eSpark-Consulting-Group/chrisbyrd-remotesensorunit/Design Files/Remote_Sensor_Unit/Deliverables/_Renderings/3D_Isometric_View.png

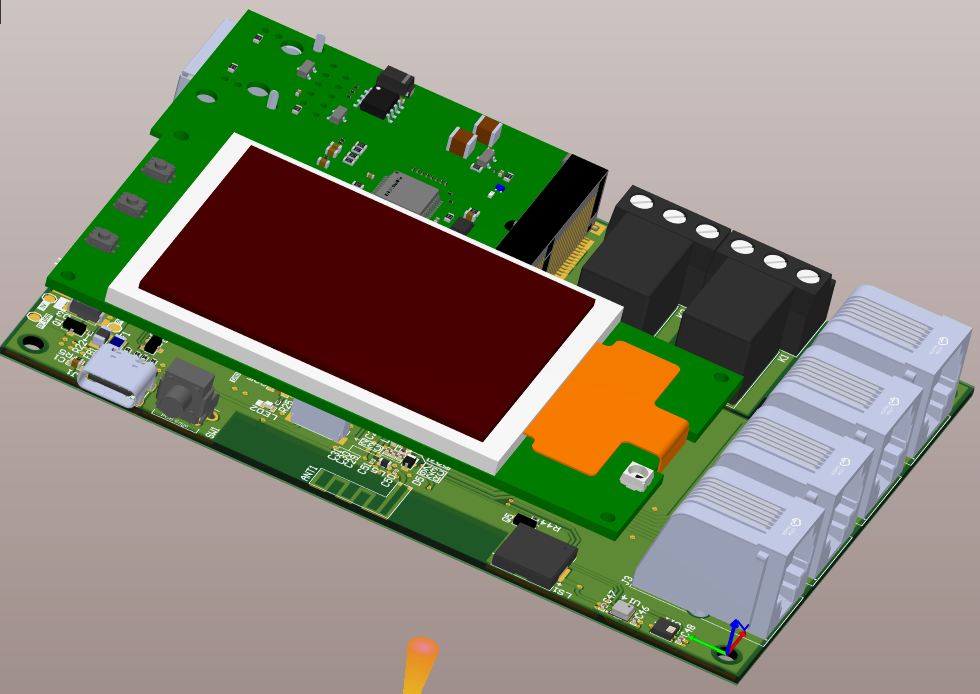
Design Files/Remote_Sensor_Unit/Deliverables/_Renderings/3D_Isometric_View.png
