eSpark-Consulting-Group/chrisbyrd-remotesensorunit/Design Files/Remote_Sensor_Unit/Deliverables/_Renderings/2D_C_View.png

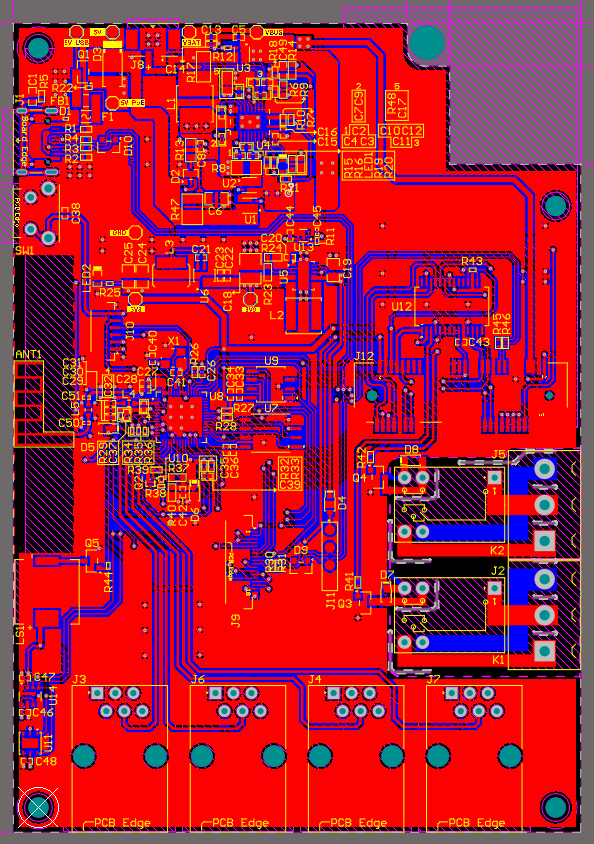
Design Files/Remote_Sensor_Unit/Deliverables/_Renderings/2D_C_View.png
