eSpark-Consulting-Group/chrisbyrd-remotesensorunit/Design Files/Remote_Sensor_Unit/BOM/Client_BOM_Remote_Sensor_Unit.xlsx

 |  | Component list |  | Bill of Materials for Project [Remote_Sensor_Unit]
 |  | Source Data From: |  | Remote_Sensor_Unit
 |  | Project: |  | Remote_Sensor_Unit
 |  | Variant: |  | None
# | Item Type | Designator | Description | Footprint | Manufacturer Part Number | Manufacturer | Value | Quantity | Quantity (5 Boards) | Remarks
1 | Antenna | ~~ANT1~~ |  | ~~ANT*~~ |  |  | ~~-~~ | ~~1~~ | ~~5~~
2 | Capacitor | C1 | CAP CER 4700PF 50V C0G/NPO 0603 | Cap-0603 | CC0603JRNPO9BN472 | Yageo | 4.7nF | 1 | 5
3 | Capacitor | C2, C3, C4, C10, C11, C12, C15, C20, C21, C23, C26, C31, C32, C33, C36, C37, C39, C42, C43, C46, C47, C48 | CAP CER 0.1UF 100V X5R 0402 | Cap-0402 | GRM155R62A104KE14D | Murata | 0.1uf | 22 | 110
4 | Capacitor | C5, C7, C13, C14, C22, C29, C34 | CAP CER 10UF 10V X5R 0402 | Cap-0402 | CL05A106MP5NUNC | Samsung | 10uF | 7 | 35
5 | Capacitor | C6 | CAP CER 2.2UF 25V X5R 0805 | Cap-0805 | CC0805KKX5R8BB225 | Yageo | 2.2uF | 1 | 5
6 | Capacitor | C8, C16, C17, C27, C30, C35, C38, C44 | CAP CER 1UF 50V X5R 0402 | Cap-0402 | UMK105CBJ105MV-F | Taiyo Yuden | 1uF | 8 | 40
7 | Capacitor | C9 | CAP CER 0.047UF 25V X7R 0402 | Cap-0402 | GRM155R71E473KA88D | Murata | 47nF | 1 | 5
8 | Capacitor | C18 | CAP CER 100UF 16V X5R 1210 | Cap-1210 | EMK325ABJ107MM-P | Taiyo Yuden | 100uF | 1 | 5
9 | Capacitor | C19, C24, C25 | CAP CER 22UF 25V X5R 0805 | Cap-0805 | CC0805MKX5R8BB226 | Yageo | 22uF | 3 | 15
10 | Capacitor | C28 | CAP CER 10000PF 50V X7R 0402 | Cap-0402 | CC0402KRX7R9BB103 | Yageo | 10nF | 1 | 5
11 | Capacitor | C40, C41 | CAP CER 22PF 50V C0G/NPO 0402 | Cap-0402 | CC0402JRNPO9BN220 | Yageo | 22PF | 2 | 10
12 | Capacitor | C45 | CAP CER 1000PF 25V X5R 0201 | CAP-0201 | CC0201KRX5R8BB102 | Yageo | 1nF | 1 | 5
13 | Capacitor | C49 | CAP CER 330PF 50V C0G/NPO 0603 | Cap-0603 | CC0603JRNPO9BN331 | Yageo | 330pF | 1 | 5
14 | Capacitor | C50 | CAP CER 2.7PF 50V C0G/NPO 0201 | CAP-0201 | CC0201CRNPO9BN2R7 | Yageo | 2.7pF | 1 | 5
15 | Capacitor | C51 | CAP CER 4.7PF 50V C0G/NPO 0201 | CAP-0201 | CC0201BRNPO9BN4R7 | Yageo | 4.7pF | 1 | 5
16 | Diode | D1 | TVS DIODE 5VWM 6.3VC DSN0603-2 | DSN0603-2 | PESD5V0H1BSFYL | Nexperia | - | 1 | 5
17 | Diode | D2 | DIODE SCHOTTKY 30V 100MA SOT323 | SOT_323 | BAT54CWT1G | ON Semiconductor / Fairchild | - | 1 | 5
18 | Diode | D3 | Schottky Barrier Diode SK36, DO-214AB, 3A/60V | SMA | SS36 | ON Semiconductor / Fairchild | - | 1 | 5
19 | Diode | D4, D7, D8 | DIODE GEN PURP 75V 150MA SOD323 | SOD-323 | 1N4148WS-7-F | Diodes | - | 3 | 15
20 | ESD Diode | D5 | 15V 19A 3.3V 4V Bidirectional SOD-323 ESD Protection Devices ROHS | SOD-323 | UDD32C03L01 | Brightking | - | 1 | 5
21 | Diode | D6 | DIODE ZENER 3.3V 200MW SOD323F | SOD323F | MM3Z3V3B | ON Semiconductor / Fairchild | - | 1 | 5
22 | Diode | D9, D10 | 16A 20V 7V 5V@Max Unidirectional SOT-23 TVS ROHS | Sot-23 | ESD5302F-3/TR | WILLSEMI | - | 2 | 10
23 | Fuse | F1 | PTC RESET FUSE 6V 3A 1206 | Fuse 1206 (3216 Metric) | 1206L300SLTHYR | Littelfuse | - | 1 | 5
24 | Ferrite Bead | FB1 | FERRITE BEAD 120 OHM 1206 1LN | IND-1206 | BLM31PG121SN1L | Murata | - | 1 | 5
25 | USB Connector | J1 | 250mA 1 16 Female Type-C SMD USB Connectors ROHS | TYPE-C-31-M-12_ | TYPE-C-31-M-12 | Korean Hroparts Elec | - | 1 | 5
26 | Terminal Block | J2, J5 | 1x3P 18A -40℃~+105℃ 250V Black 12~30 Straight pin 5.08mm 2.5 1 3 Plugin,P=5.08mm Screw terminal ROHS | DB128L-5.08-3P-BK-S | DB128L-5.08-3P-BK-S | DIBO | - | 2 | 10
27 | RJ11 Ethernet Connector | J3, J4, J6, J7 | RJ11 RJReceptacle No 1 Plugin Ethernet Connectors/Modular Connectors (RJ45 RJ11) ROHS | DS1133-01-S60BPS | DS1133-01-S60BPS | CONNFLY Elec | - | 4 | 20
28 | JST Connector | J8 | 1x2P 1 1.25mm Male pin 2 -40℃~+85℃ Surface Mount SMD,P=1.25mm Wire To Board / Wire To Wire Connector ROHS | 1.25-2PWB | 1.25-2PWB | DEALON | - | 1 | 5
29 | FPC Connector | J9 | Clamshell -25℃~+85℃ 18P Bottom Contact Surface Mount 0.5mm SMD,P=0.5mm FFC/FPC Connectors ROHS | F0502-B-18-15T-R | F0502-B-18-15T-R | XFCN | - | 1 | 5
30 | Connector | J10 | 1x6P SH 1 1mm 6 SMD,P=1mm Wire To Board / Wire To Wire Connector ROHS | Voltlink Target | C145963 | BOOMELE | - | 1 | 5
31 | Pogo Connector | J11 | Pogo Pad 2.5mm 4 Pin | Pogo 4 Pin | POGO Connector 4 Pin |  | - | 1 | 5
32 | mPCI-E Connector | J12 | 0.8mm mPCI-E Surface Mount 52 SMD,P=0.8mm Card Edge Connectors ROHS | 91304-99-052R2 | 91304-99-052R2 | UMAX | - | 1 | 5
33 | Relay | K1, K2 | RELAY GEN PURPOSE SPDT 3A 3V | J102K1CS33VDC.20 | J102K1CS33VDC.20 | CIT Relay & Switch | - | 2 | 10
34 | Inductor | L1 | FIXED IND 3.3UH 4.2A 35.1MOHM SM | VLS5045EX-3R3N | VLS5045EX-3R3N | TDK | 3.3uH | 1 | 5
35 | Inductor | L2 | FIXED IND 2.2UH 3.1A 29 MOHM SMD | NRS5024T2R2NMGJ | NRS5024T2R2NMGJ | Taiyo Yuden | 2.2uH | 1 | 5
36 | Inductor | L3 | 2.7A 6.8uH ±20% 50mΩ SMD Power Inductors ROHS | LVC505040-6R8M-N_ | LVC505040-6R8M-N | Chlisin Elec | 6.8uH | 1 | 5
37 | Inductor | L4 | 2nH ±0.3nH 0603 Inductors | IND-0603 (1608 Metric) | SDCL1608C2N0STDF | Sunlord | 2nH | 1 | 5
38 | Inductor | L5 | 700mA 1.6nH ±10% 40mΩ 0603 Inductors (SMD) ROHS | IND-0603 (1608 Metric) | FHW0603UC1N6KST | FH | 1.6nH | 1 | 5
39 | LED | LED1, LED2 | Red 632nm LED Indication - Discrete 2.05V 0603 (1608 Metric) | LED-0603 | 19-21/R7C-AK1L2BY/3T | Everlight Elec | - | 2 | 10
40 | BUZZER | LS1 | BUZZER PIEZO 1.5V 9X9MM SMD | PKMCS0909E4000-R1 | PKMCS0909E4000-R1 | Murata | - | 1 | 5
41 | Test Point | ~~P1, P2, P3, P4, P5, P6, P7, P8~~ | ~~Test Point ON~~ | ~~Test-point~~ | ~~TEST POINT~~ | ~~-~~ | ~~-~~ | ~~8~~ | ~~40~~
42 | Mosfet | Q1 | 30V 4.6A 38mΩ@10V,4.3A 1.3W 1V@250uA 90pF@15V P Channel 1.25nF@15V 24.8nC@10V +150℃@(Tj) SOT-23-3L MOSFETs ROHS | SOT-23-3L_ | WPM3401-3/TR | WILLSEMI | - | 1 | 5
43 | Mosfet | Q2 | 40V 100mW 100@10mA,1V 200mA 300MHz 300mV@50mA,5mA NPN -55℃~+150℃@(Tj) SOT-723 Bipolar Transistors - BJT ROHS | SOT-723 | MMBT3904M | TECH PUBLIC | - | 1 | 5
44 | Mosfet | Q3, Q4, Q5 | TRANS NPN 40V 0.6A SMD SOT23-3 | SOT-23 | MMBT2222A-7-F | Diodes | - | 3 | 15
45 | Resistor | R1, R2 | RES SMD 5.1 KOHM 1% 1/5W 0402 | Res-0402 | ERJ-PA2F5101X | Panasonic | 5.1K | 2 | 10
46 | Resistor | R3, R4, R30, R31, R45, R46 | RES 0 OHM JUMPER 1/16W 0402 | Res-0402 | RC0402FR-070RL | Yageo | 0R | 6 | 30
47 | Resistor | R5 | RES 1M OHM 0.1% 1/16W 0402 | Res-0402 | MCS0402MD1004BE000 | Vishay BCcomponents | 1MR | 1 | 5
48 | Resistor | R6, R14, R24, R37, R40 | RES SMD 100K OHM 0.1% 1/10W 0603 | Res-0603 | RT0603BRD07100KL | Yageo | 100K | 5 | 25
49 | Resistor | R7 | RES 232K OHM 0.1% 1/16W 0402 | Res-0402 | RT0402BRD07232KL | Yageo | 232k | 1 | 5
50 | Resistor | R8 | RES 0.02 OHM 1% 1W 1206 | Res-1206 | PA1206FRF470R02L | Yageo | 20mR | 1 | 5
51 | Resistor | R9 | RES 43K OHM 1% 1/16W 0402 | Res-0402 | RC0402FR-0743KL | Yageo | 43k | 1 | 5
52 | Resistor | R10 | RES SMD 15K OHM 0.1% 1/16W 0402 | Res-0402 | RT0402BRD0715KL | Yageo | 15K | 1 | 5
53 | Resistor | R11, R22, R29, R34, R35, R36, R43 | RES SMD 10K OHM 1% 1/20W 0201 | Res-0201 | RC0201FR-0710KL | Yageo | 10K | 7 | 35
54 | Resistor | R12, R38, R44 | RES 1K OHM 1% 1/20W 0201 | Res-0201 | RC0201FR-071KP | Yageo | 1K | 3 | 15
55 | Resistor | R13 | RES 10 OHM 1% 1/8W 0805 | RES-0805 | TNPW080510R0FEEA | Vishay | 10R | 1 | 5
56 | Resistor | R15, R16 | RES 4.02K OHM 1% 1/16W 0402 | Res-0402 | RC0402FR-074K02L | Yageo | 4.02K | 2 | 10
57 | Resistor | R17 | RES 0.01 OHM 1% 1W 1206 | Res-1206 | PE1206FRM470R01L | Yageo | 10mR | 1 | 5
58 | Resistor | R18 | RES 39K OHM 1% 1/16W 0402 | Res-0402 | RC0402FR-0739KL | Yageo | 39K | 1 | 5
59 | Resistor | R19 | 100mW Thick Film Resistors ±1% 5.23kΩ 0603 Chip Resistor - Surface Mount ROHS | Res-0603 | FRC0603F5231TS | FOJAN | 5.23K | 1 | 5
60 | Resistor | R20 | RES 30.1K OHM 1% 1/10W 0603 | Res-0603 | RC0603FR-0730K1L | Yageo | 30.1K | 1 | 5
61 | Resistor | R21 | RES 1.5K OHM 1% 1/16W 0402 | Res-0402 | RC0402FR-071K5L | Yageo | 1.5K | 1 | 5
62 | Resistor | R23 | Res Thin Film 0603 680K Ohm 0.1% 1/10W ±50ppm/°C Molded SMD SMD Paper T/R | Res-0603 | RT0603BRE07680KL | Yageo | 680K | 1 | 5
63 | Resistor | R25 | RES 470 OHM 5% 1/20W 0201 | Res-0201 | RC0201JR-07470RL | Yageo | 470R | 1 | 5
64 | Resistor | R26 | RES 499 OHM 1% 1/16W 0402 | Res-0402 | RC0402FR-07499RL | Yageo | 499R | 1 | 5
65 | Resistor | R27, R28, R32, R33, R39, R41, R42 | RES 4.7K OHM 1% 1/16W 0402 | Res-0402 | RC0402FR-074K7L | Yageo | 4.7K | 7 | 35
66 | Resistor | R47 | RES 2 OHM 5% 1/2W 1210 | Res_1210 | RC1210JR-072RL | Yageo | 2R | 1 | 5
67 | Resistor | R48 | RES 0 OHM JUMPER 1/8W 0805 | Res-0805 | RC0805FR-070RL | Yageo | 0R | 1 | 5
68 | Tactile Switch | SW1 | 50mA Lying SPST 24V Plugin Tactile Switches ROHS | 1825027-8 | 1825027-8 | TE Connectivity | - | 1 | 5
69 | IC | U1, U2 | 30V 5A 2.3W 30mΩ@4A,8V null WSON-6 MOSFETs ROHS | CSD17313Q2 | CSD17313Q2 | Texas Instruments | - | 2 | 10
70 | Mosfet | U3 | MOSFET P-CH 20V 48A 6SON | CSD25310Q2 | CSD25310Q2 | Texas Instruments | - | 1 | 5
71 | IC | U4 | IC BATT CHG LI-ION 1-3CEL 24VQFN | 24-VQFN (5.5x3.5) | BQ24133RGYR | Texas Instruments | - | 1 | 5
72 | IC | U5 | IC REG BCK BST ADJ 4A 14WDFN | DFN-14(3x4) | RT6154AGQW | Richtek | - | 1 | 5
73 | IC | U6 | IC REG BUCK 3.3V 2A TSOT26 | TSOT-23-6 | AP63203WU-7 | Diodes | - | 1 | 5
74 | IC | U7 | IC FLASH 64M SPI 133MHZ 8SOIC | SOIC-8 (208 mil) | W25Q64JVSSIQ TR | Winbond | - | 1 | 5
75 | IC | U8 | SMD IC ESP32-S3R8, DUAL-CORE MCU | 56-QFN (7x7) | ESP32-S3R8 | Espressif Systems | - | 1 | 5
76 | IC | U9 | IC AUTHENTICATION CHIP 8SOIC | SOIC-8 | ATECC608B-SSHDA-B | Microchip | - | 1 | 5
77 | IC | U10 | MOSFET P-CH 20V 3.6A 3LGA | PicoStar-3 | CSD25501F3 | Texas Instruments | - | 1 | 5
78 | IC | U11 | DFN-6-EP(3x3) Temperature and Humidity Sensor ROHS | DFN-6-EP(3x3) | HTU21D | TE Connectivity | - | 1 | 5
79 | IC | U12 | IC XPNDR 1.7MHZ I2C 28SSOP | SSOP-28-208mil | MCP23017T-E/SS | Microchip | - | 1 | 5
80 | IC | U13 | Active Low 1 VSOF-5 Monitors & Reset Circuits ROHS | VSOF-5 | BD4830FVE-TR | Rohm | - | 1 | 5
81 | Temperature Sensor | U14 | SENSOR RH PRESSURE TEMP VOC | BME680 | BME680 | Bosch Sensortec | - | 1 | 5
82 | Crystal | X1 | 40MHz SMD Crystal Resonator 15pF SMD3225-4P Crystals ROHS | X322540MPB4SI_ | X322540MPB4SI | Yangxing Tech | 40MHz | 1 | 5
83 | Peripheral | - | 5pcs 504050 JST 1.25mm 2pin 3.7V 1500mAh Rechargeable battery lipo Lithium polymer for MP3 GPS DVD bluetooth camera speaker PSP | - | Battery | - | - | 1 | 5 | Refrence Link (https://www.aliexpress.com/item/32863912048.html)
84 | Peripheral | - | - | - | USB A to A Cable | - | - | 1 | 5 | Refrence Link (https://vi.aliexpress.com/item/1005004386493582.html?pdp_np)
85 | Peripheral | - | - | - | C type Adopter | - | - | 1 | 5 | Refrence Link (https://vi.aliexpress.com/item/1005003706277852.html?pdp_np)
86 | Peripheral | - | 3m - Cable/ModularCable ROHS | - | LC-2030C | - | - | 4 | 20
