eSpark-Consulting-Group/chrisbyrd-remotesensorunit/Design Files/Remote_Sensor_Unit/Deliverables/_Supporting Files/RemoteSensorUnit-v1.0.DXF

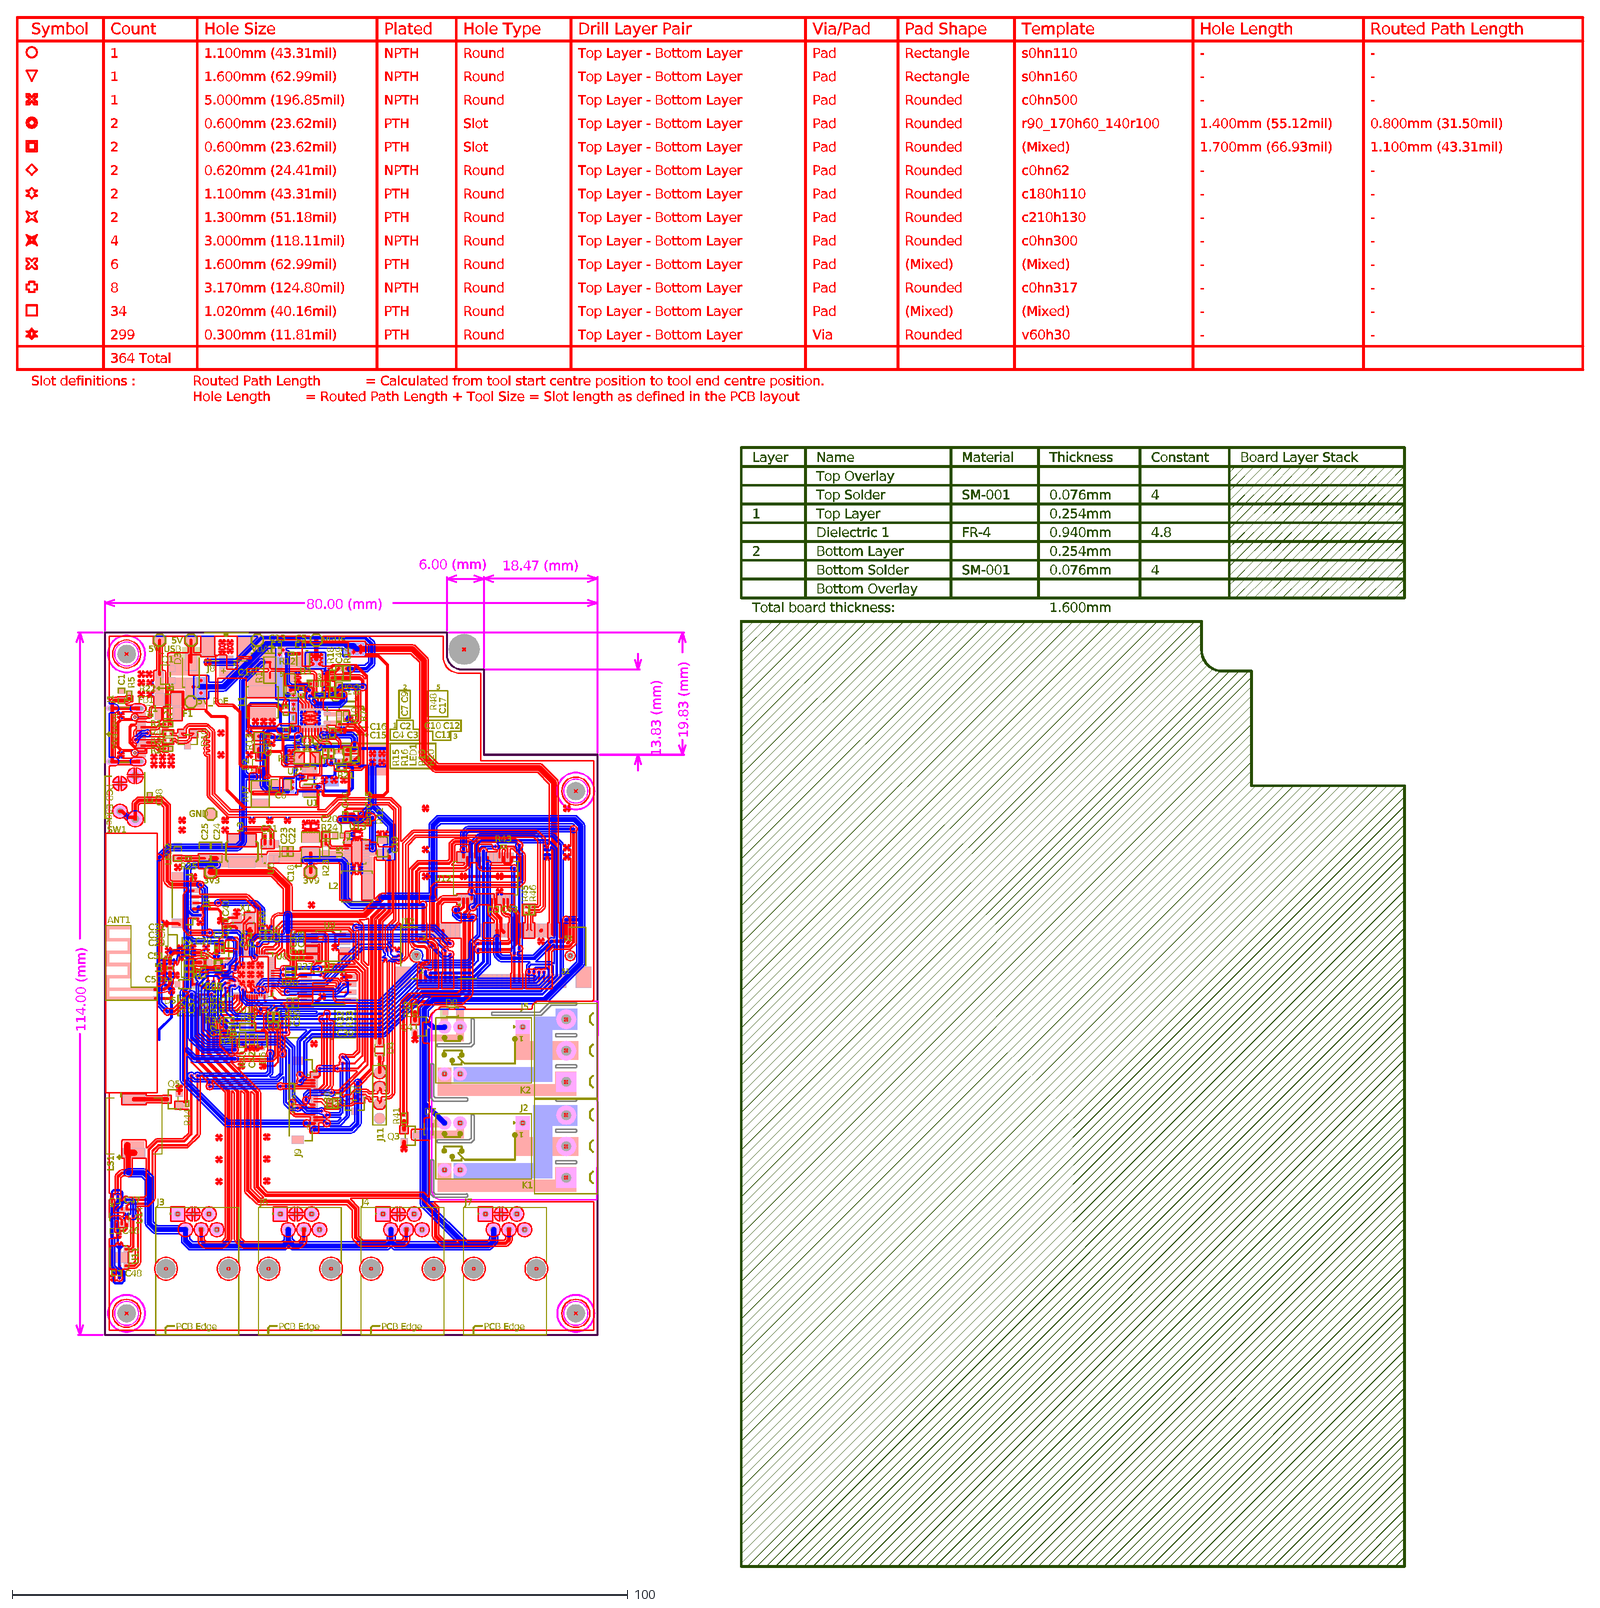
[picture p7: CAD file, 2024-02-20]
Design Files/Remote_Sensor_Unit/Deliverables/_Supporting Files/RemoteSensorUnit-v1.0.DXF
5V
VBAT
GND
3V3
3V9
VBUS
5V_PoE
5V_USB
+
5
4
3
2
1
Routed Path Length
-
0.800mm (31.50mil)
1.100mm (43.31mil)
Hole Length
1.400mm (55.12mil)
1.700mm (66.93mil)
Template
s0hn110
s0hn160
c0hn500
r90_170h60_140r100
(Mixed)
c0hn62
c180h110
c210h130
c0hn300
c0hn317
v60h30
Pad Shape
Rectangle
Rounded
Via/Pad
Pad
Via
Drill Layer Pair
Top Layer - Bottom Layer
Hole Type
Round
Slot
Plated
NPTH
PTH
Hole Size
1.600mm (62.99mil)
5.000mm (196.85mil)
0.600mm (23.62mil)
0.620mm (24.41mil)
1.300mm (51.18mil)
3.000mm (118.11mil)
3.170mm (124.80mil)
1.020mm (40.16mil)
0.300mm (11.81mil)
Count
364 Total
6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
