eSpark-Consulting-Group/chrisbyrd-remotesensorunit/(list of files, cad)

Other CAD files:
Design Files/Remote_Sensor_Unit/Deliverables/_Supporting Files/RemoteSensorUnit-v1.0.DWG
