eSpark-Consulting-Group/chrisbyrd-remotesensorunit/Design Files/Remote_Sensor_Unit/Deliverables/_Schematics/Remote_Sensor_Unit-v1.0.pdf

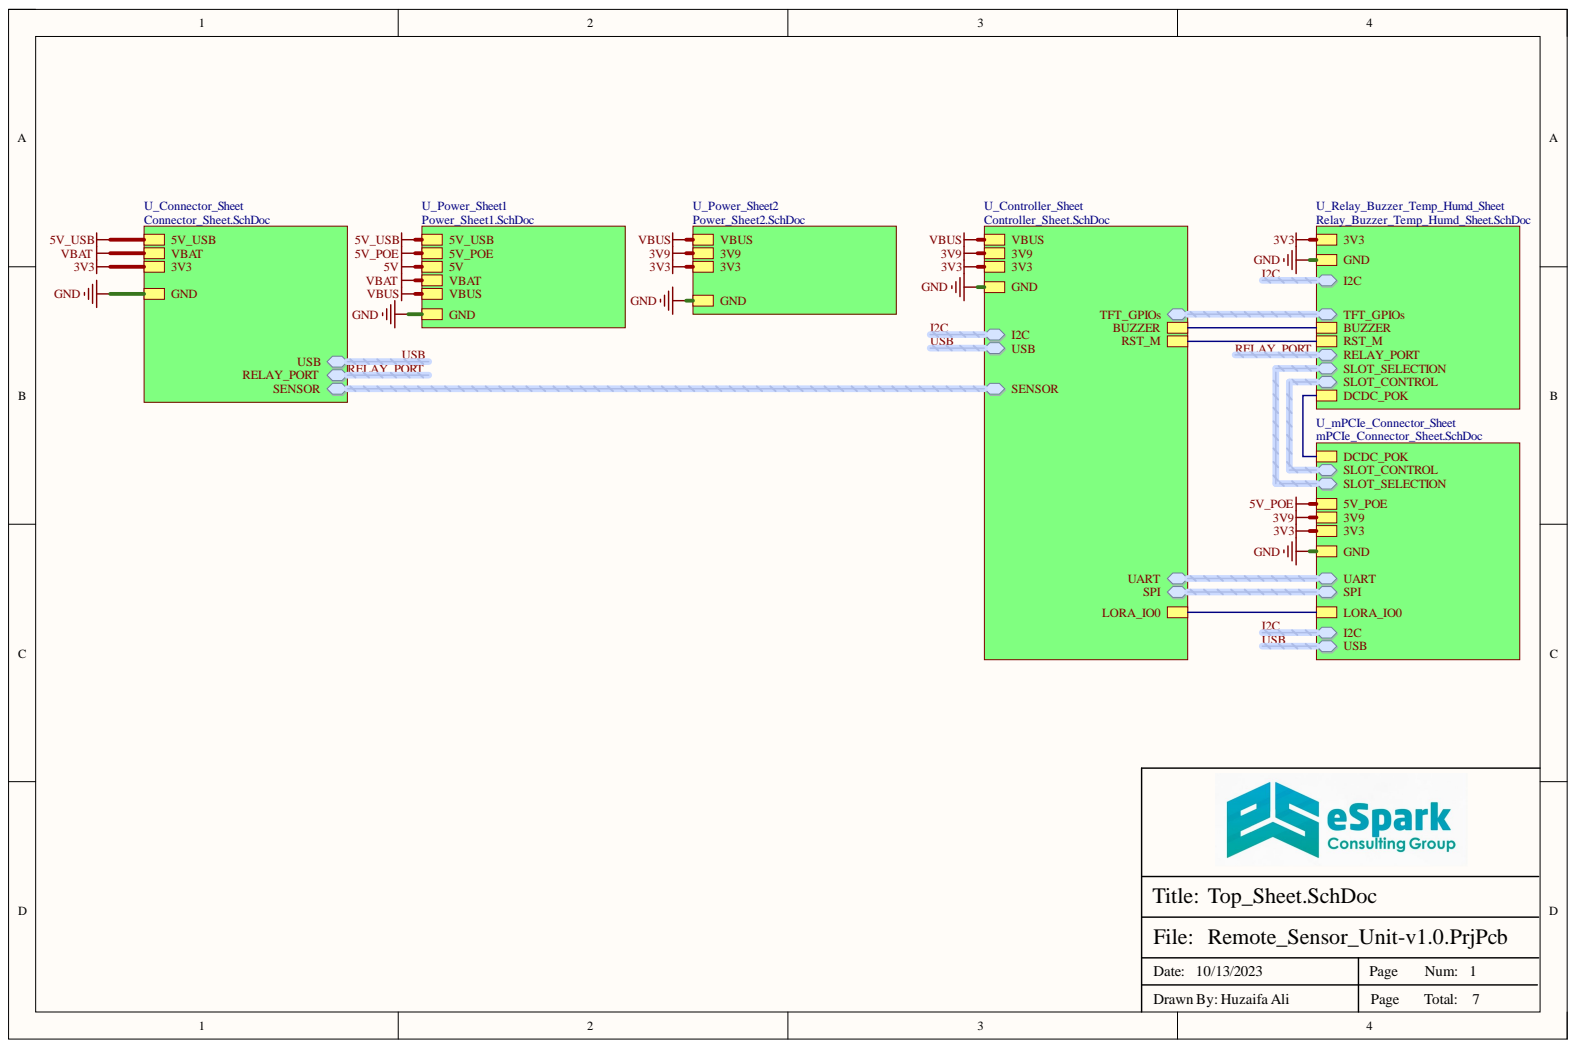
[picture p8: page 1]

Dat e : 1 0 / 1 3 / 2 0 2 3 | Pag e N u m : 17

D raw n B y : H uzai fa A l i | Pag e To t al :

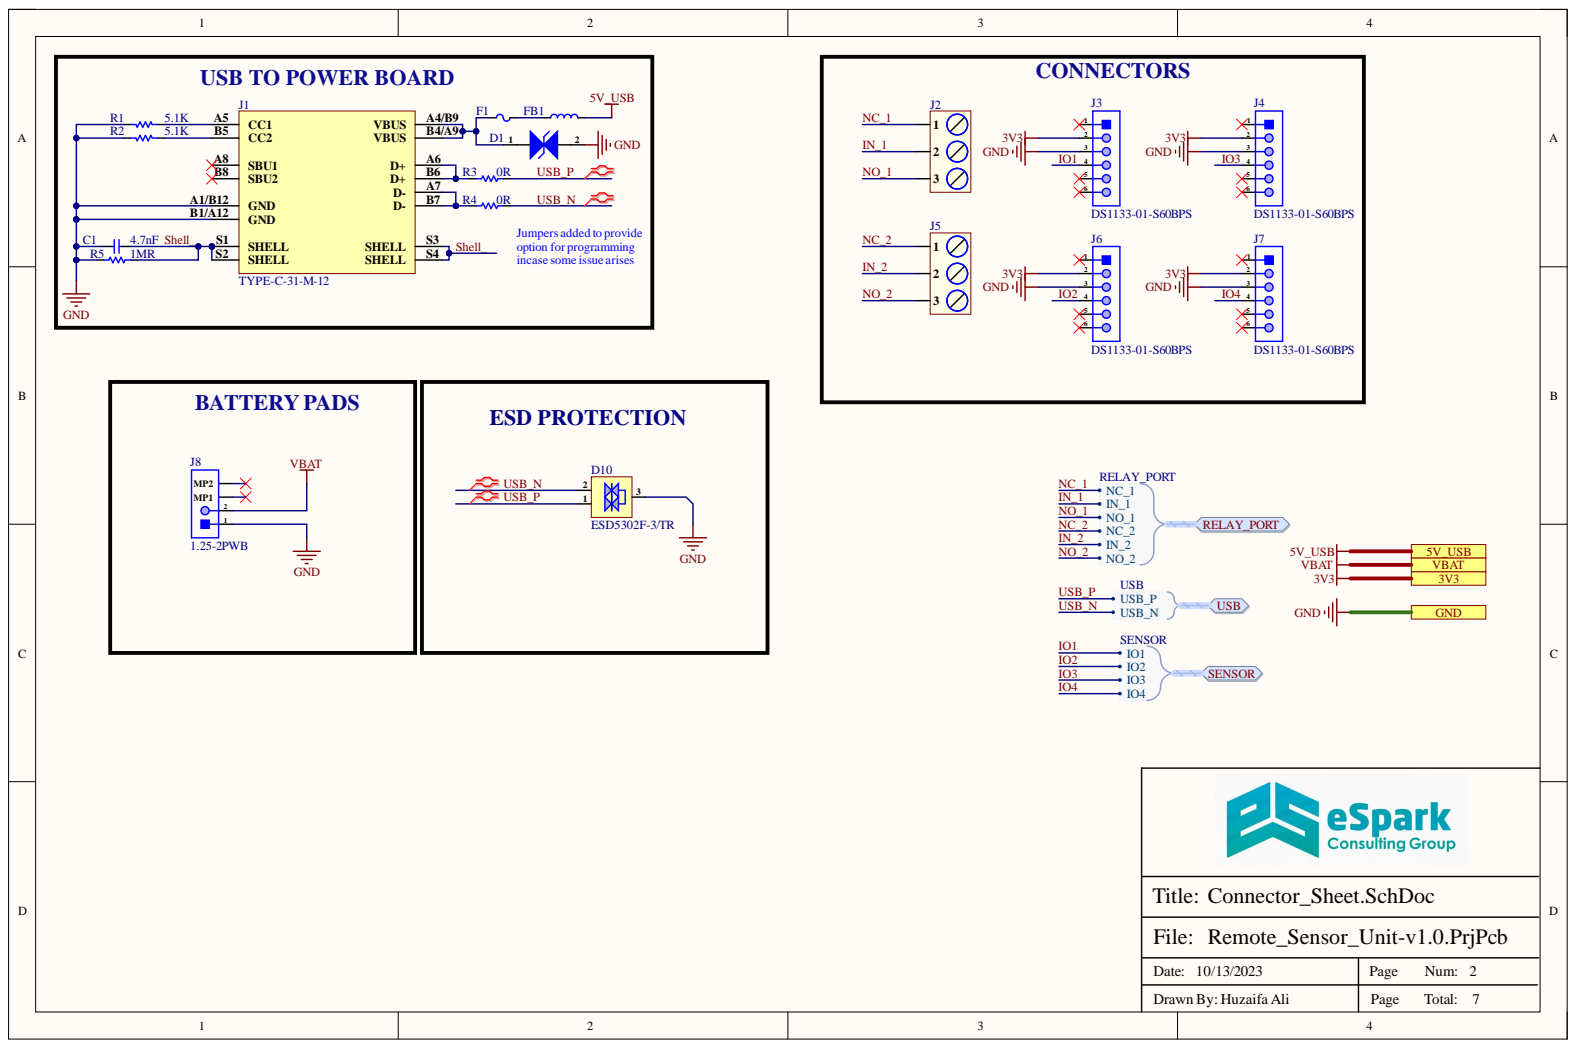
[picture p9: page 2]

Dat e : 1 0 / 1 3 / 2 0 2 3 | Pag e N u m : 27

D raw n B y : H uzai fa A l i | Pag e To t al :

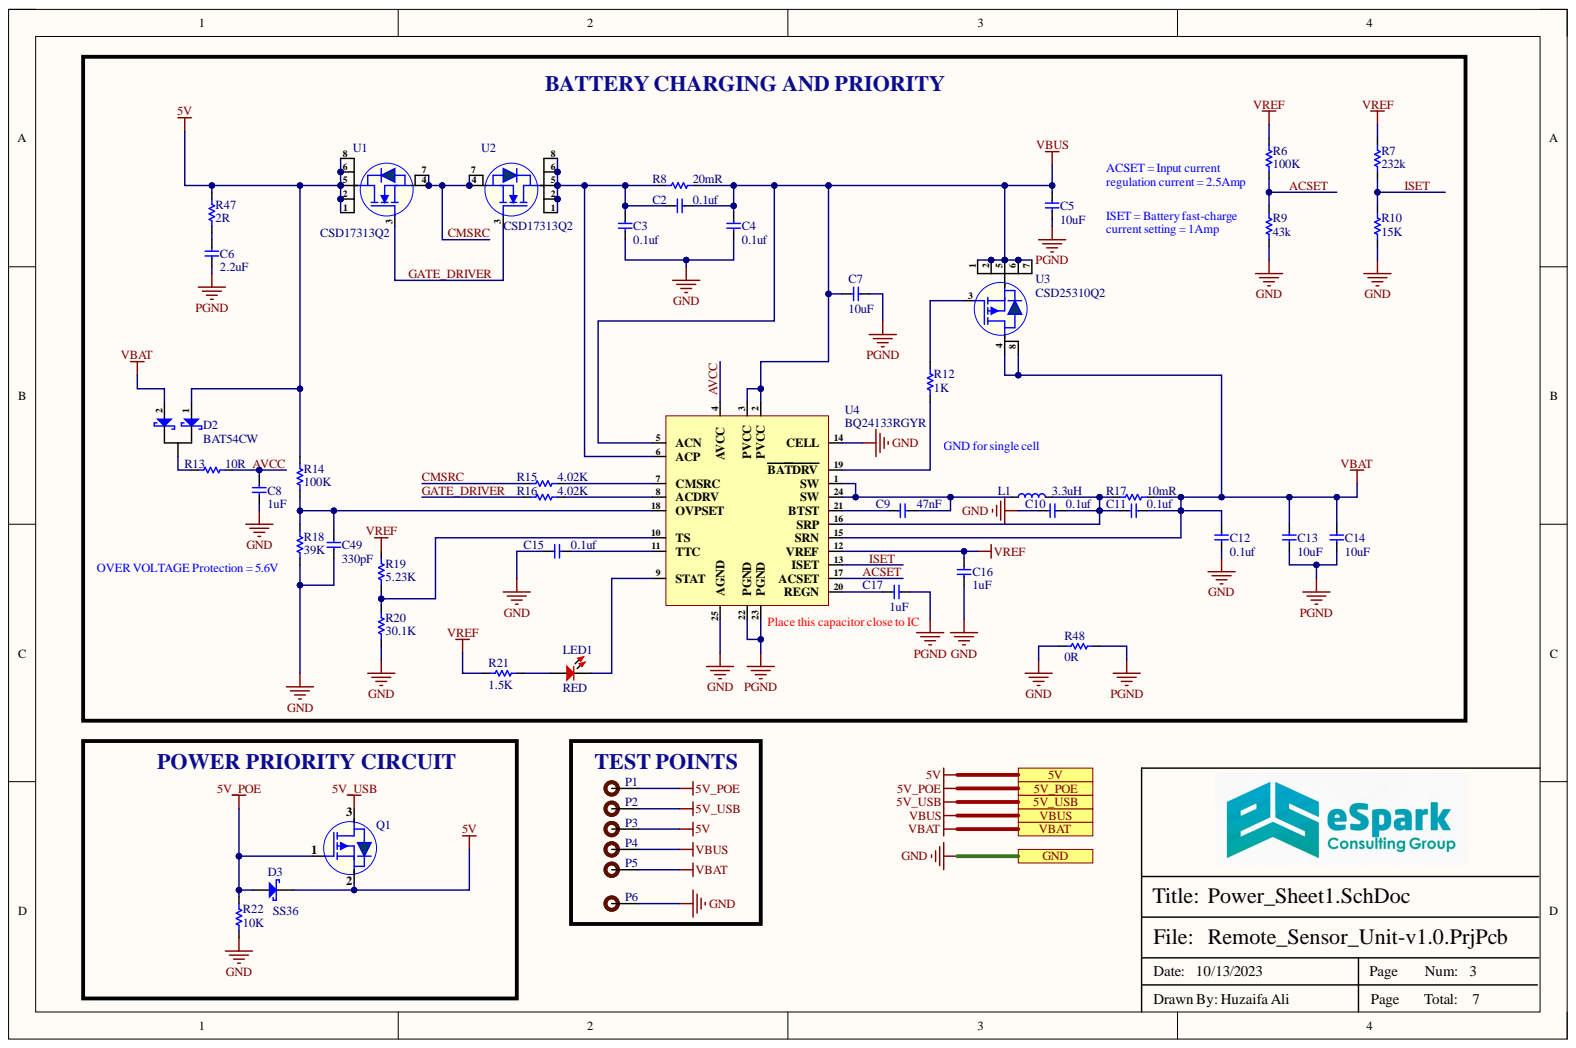
[picture p10: page 3]

BATTERY CHARGING AND PRIORITY

ISET =Battery fast-charge
current setting = 1Amp

Place this capacitor close to IC

POWER PRIORITY CIRCUIT

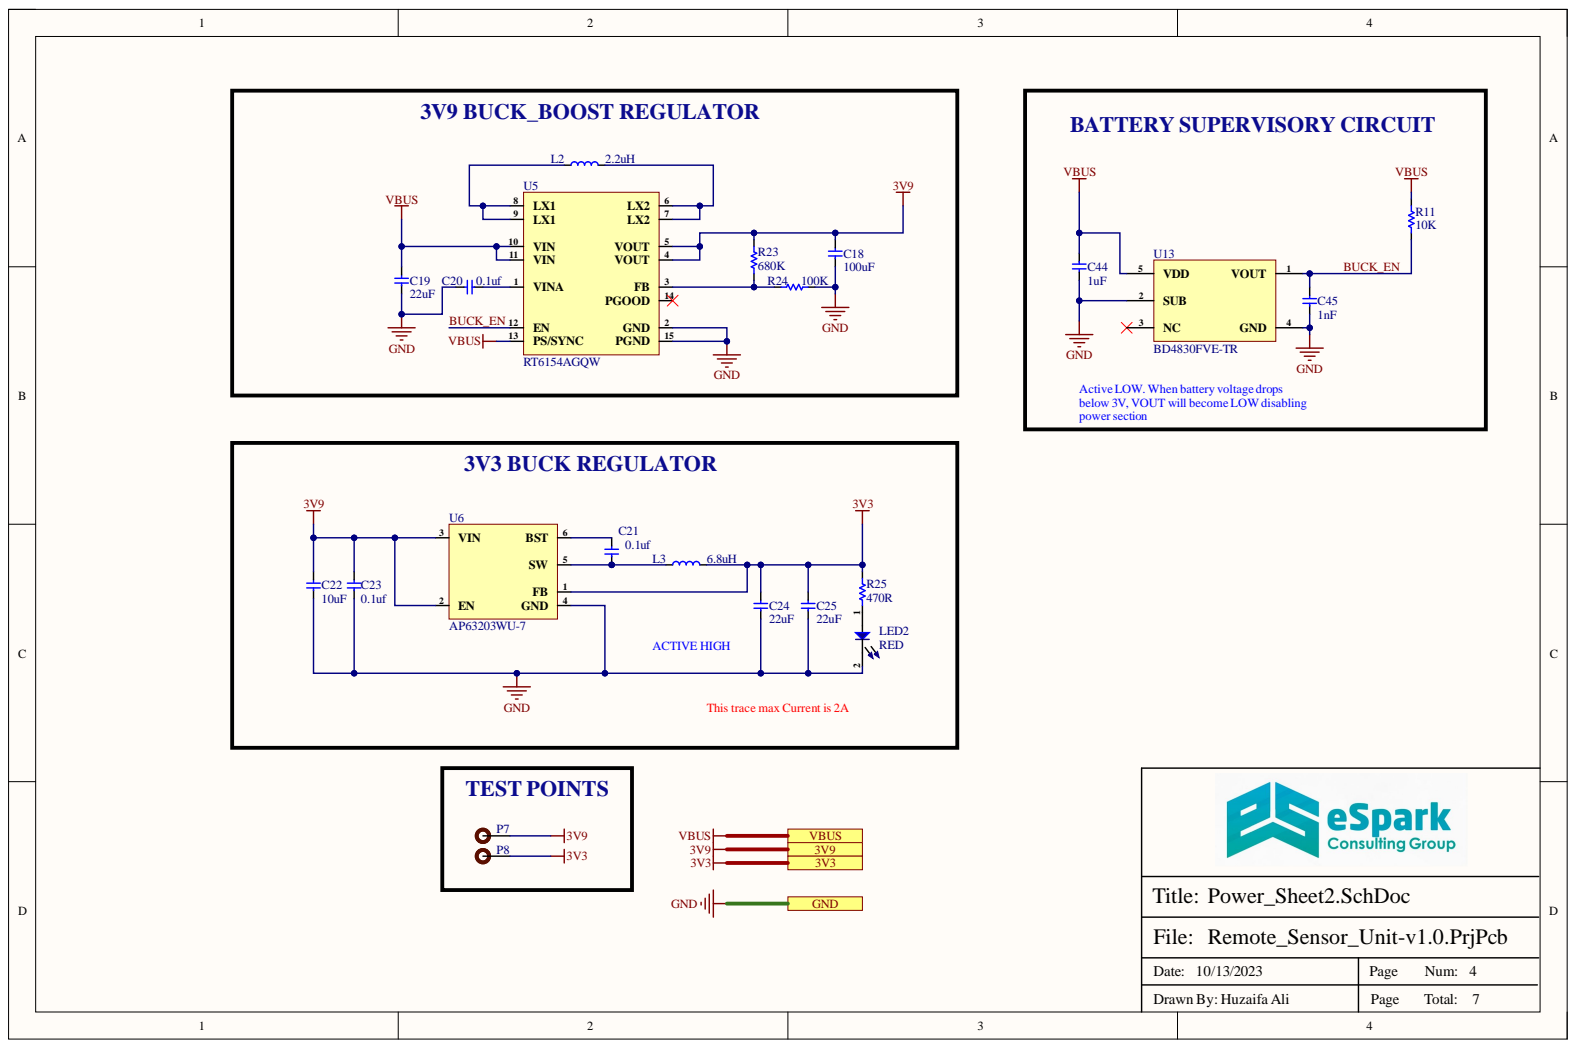
[picture p11: page 4]

Active LOW. When battery voltage drops
below 3V, VOUT will become LOW disabling
powersection

This trace max Current is 2A

Date: 10/13/2023 | Page Num: 4

Drawn By: Huzaifa Ali | Page Total: 7

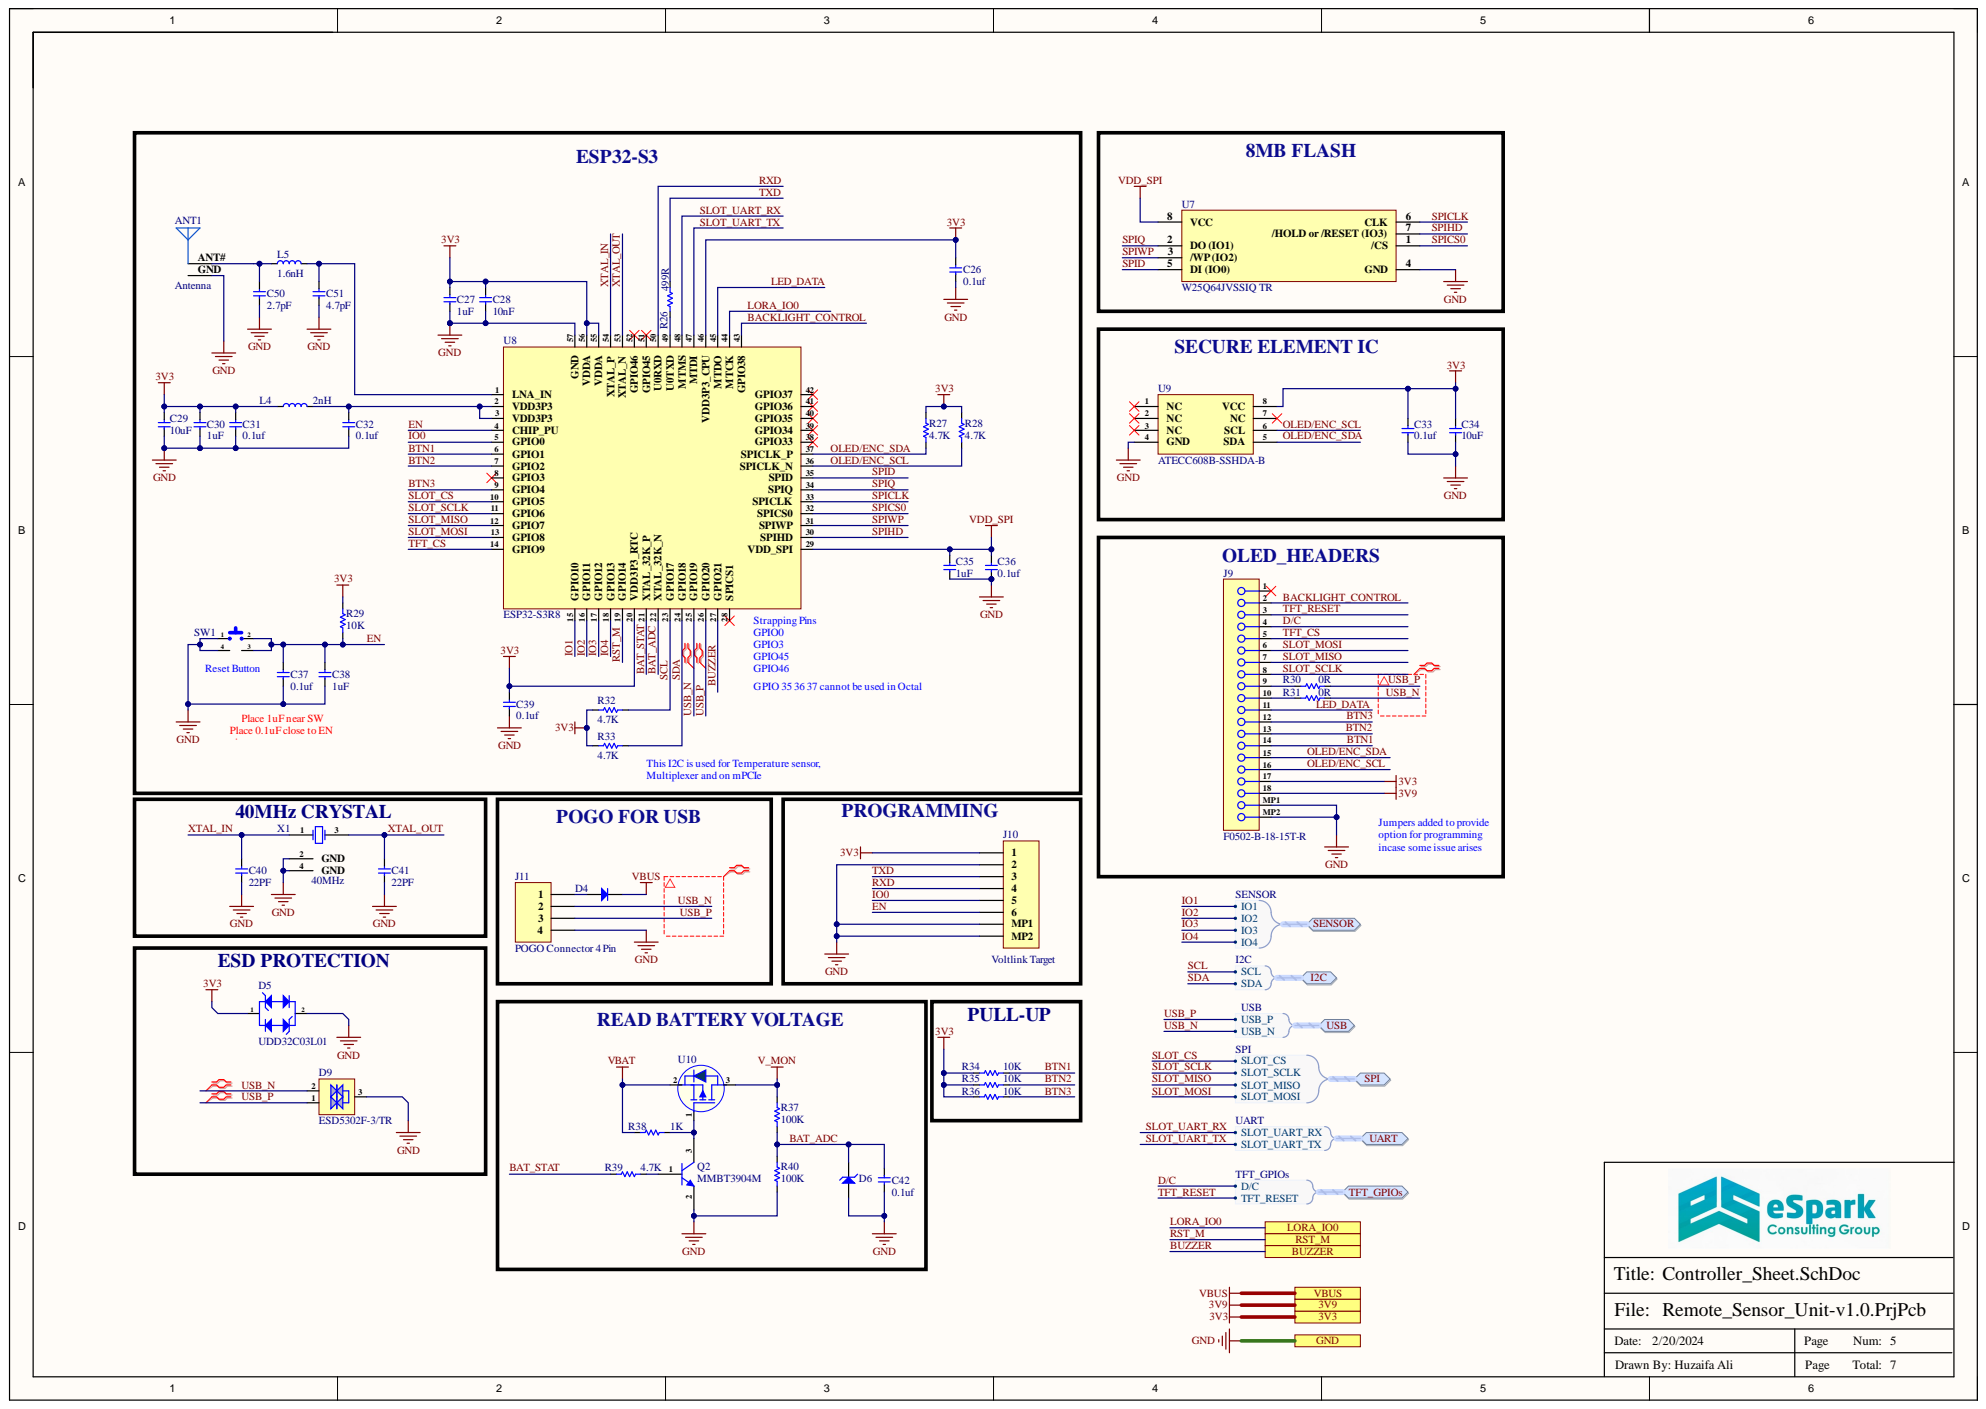
[picture p12: page 5]

LORA_IO0
BACKLIGHT_CONTROL

42 PIO38 43 MTCK 44 MTDO 45 VDD3P3_CPU 46 MTDI 47 MTMS 48 U0TXD 49 U0RXD 50 GPIO45 51 GPIO46 52 XTAL_N 53 XTAL_P 54 VDDA 55 VDDA 56 GND 57

Place 1uF near SW
Place 0.1uF close to EN
pin

This I2C is used for Temperature sensor,
Multiplexer and on mPCIe

Jumpers added to provide
option for programming
incase some issue arises

Date: 2/20/2024 | Page Num: 5

Drawn By: Huzaifa Ali | Page Total: 7

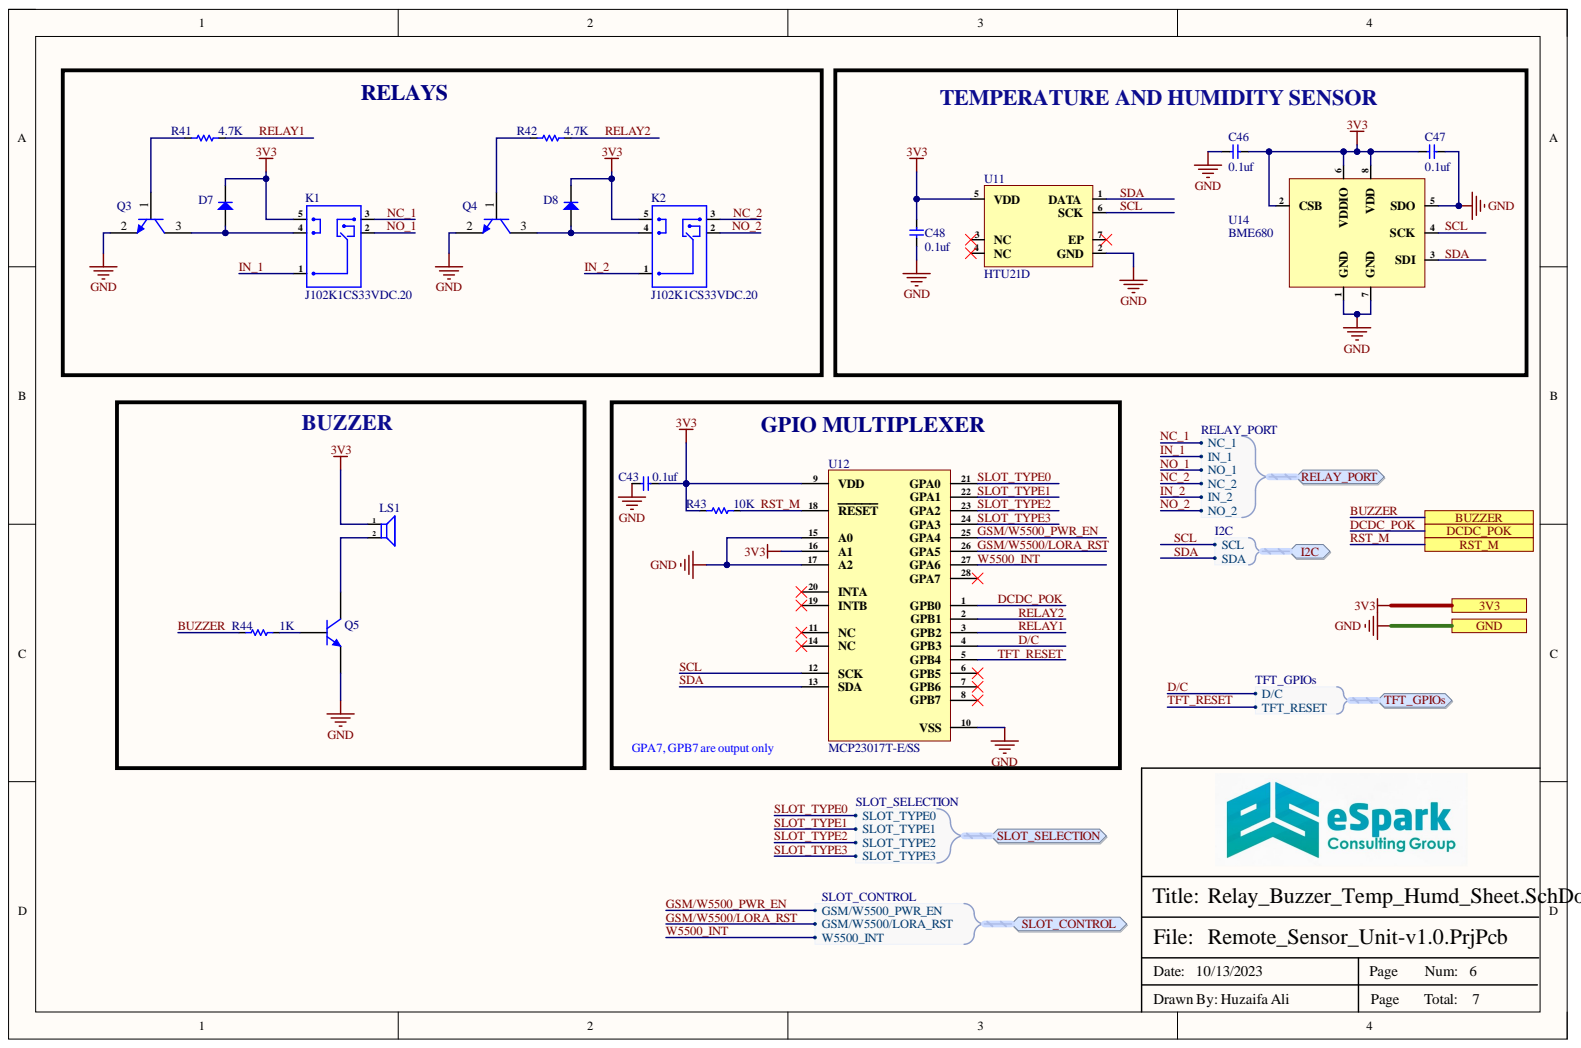
[picture p13: page 6]

TEMPERATURE AND HUMIDITY SENSOR

Date: 10/13/2023 | Page Num: 6

Drawn By: Huzaifa Ali | Page Total: 7

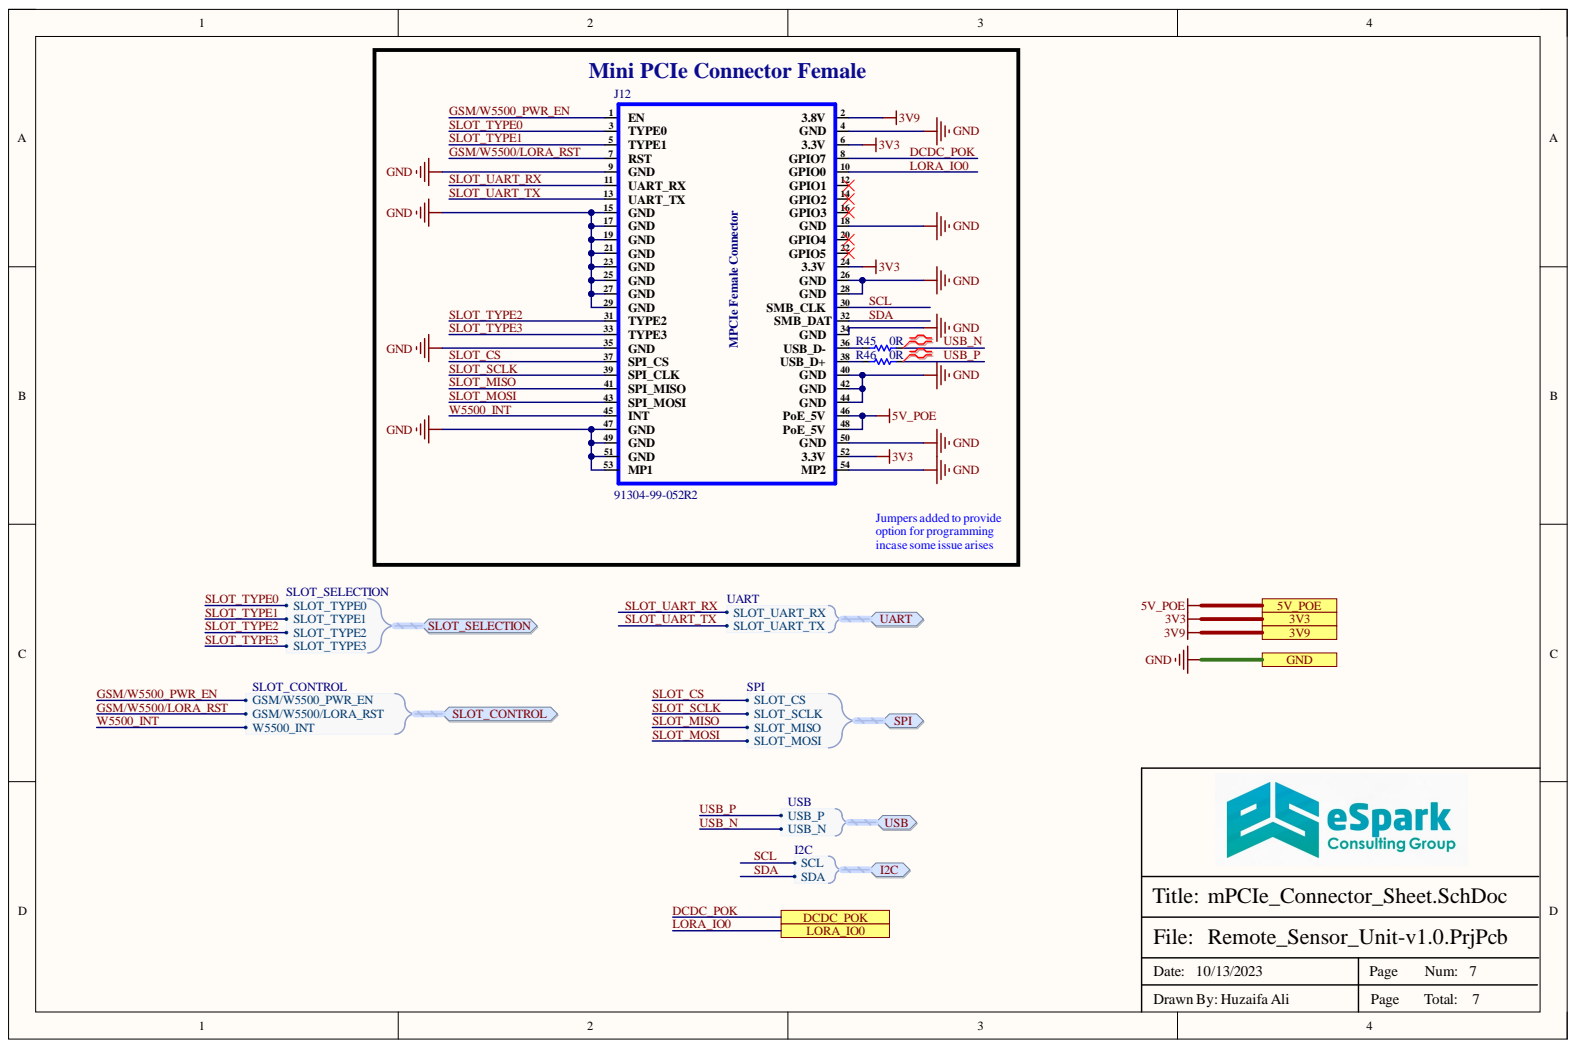
[picture p14: page 7]

Mini PCIe Connector Female

Jumpers added to provide
option for programming
incase some issue arises

Date: 10/13/2023 | Page Num: 7

Drawn By: Huzaifa Ali | Page Total: 7
