eSpark-Consulting-Group/chrisbyrd-remotesensorunit/Design Files/Remote_Sensor_Unit/Deliverables/_Schematics/Assembly Drawing.pdf

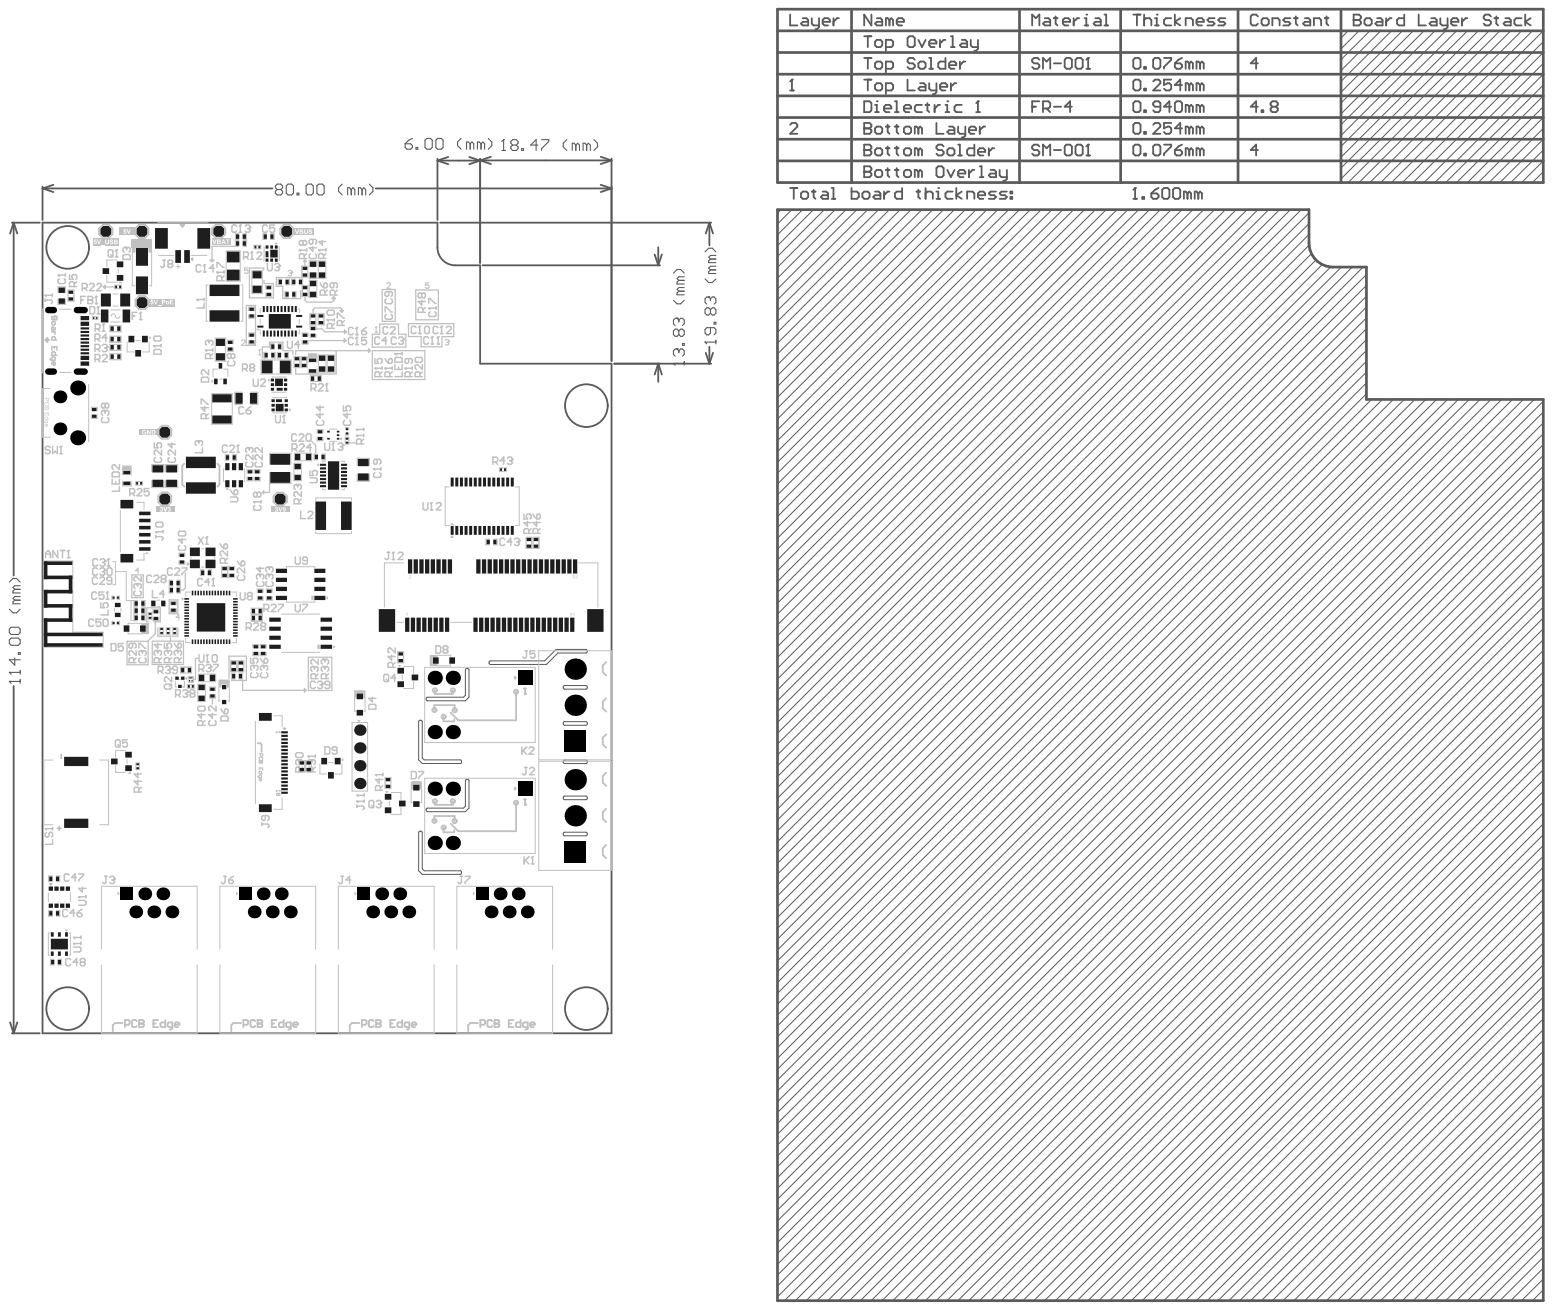
[picture p15: page 1]

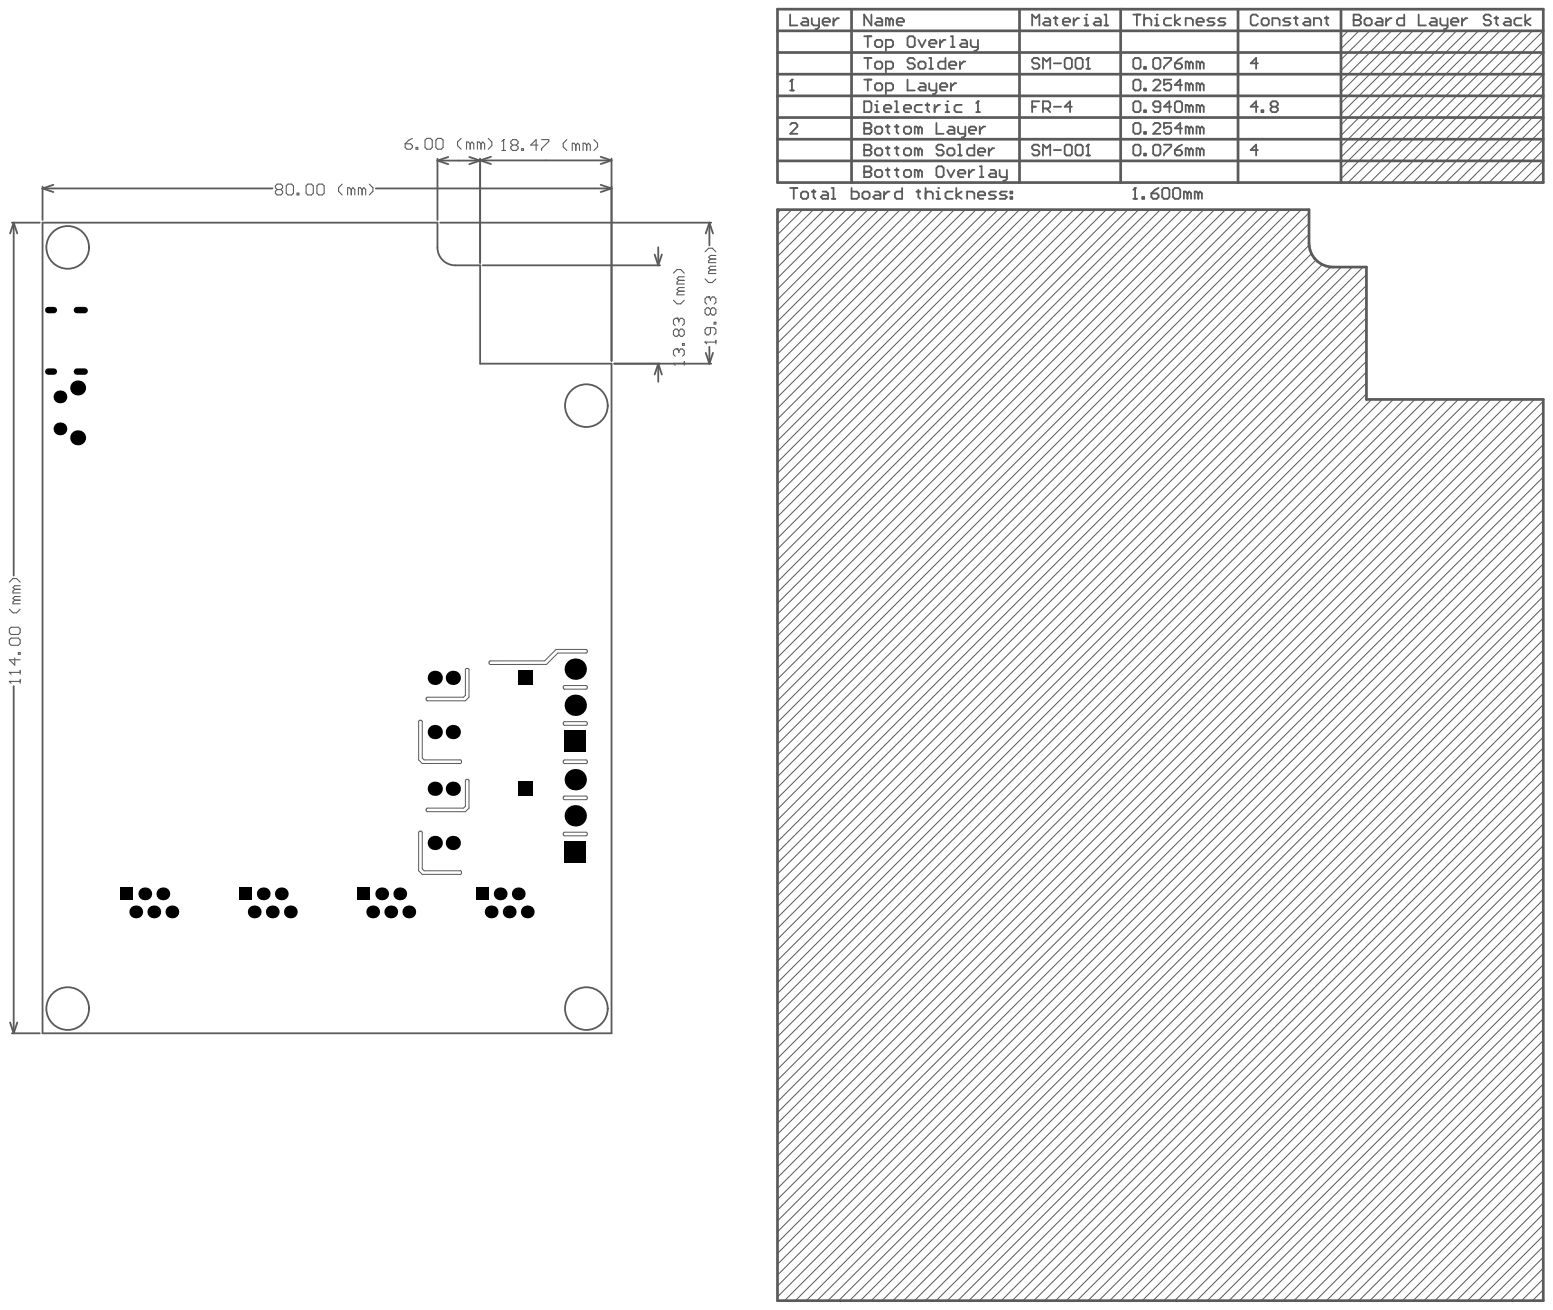
[picture p16: page 2]
