eSpark-Consulting-Group/chrisbyrd-remotesensorunit/(list of files, drawings)

Other design files:
Design Files/Remote_Sensor_Unit/Connector_Sheet.SchDoc
Design Files/Remote_Sensor_Unit/Controller_Sheet.SchDoc
Design Files/Remote_Sensor_Unit/mPCIe_Connector_Sheet.SchDoc
Design Files/Remote_Sensor_Unit/Power_Sheet1.SchDoc
Design Files/Remote_Sensor_Unit/Power_Sheet2.SchDoc
Design Files/Remote_Sensor_Unit/Relay_Buzzer_Temp_Humd_Sheet.SchDoc
Design Files/Remote_Sensor_Unit/Remote_Sensor_Unit-v1.0.PrjPcb
Design Files/Remote_Sensor_Unit/Remote_Sensor_Unit-v1.1.PrjPcb
Design Files/Remote_Sensor_Unit/RemoteSensorUnit-v1.0.PcbDoc
Design Files/Remote_Sensor_Unit/Top_Sheet.SchDoc
