eSpark-Consulting-Group/chrisbyrd-remotesensorunit/(commit log)

2023-07-11 #1 Schematic in progress
    [Connector_Sheet.SchDoc, Controller_Sheet.SchDoc, Remote_Sensor_Unit.PrjPcb, Sheet1.SchDoc, mPCIE_Sheet.SchDoc, mPCIe_Connector_Sheet.SchDoc]
2023-08-16 #1 Schematic in progress- power sheet remaining
    [Remote_Sensor_Unit.PrjPcb, Sheet3.SchDoc, Sheet4.SchDoc]
2023-08-17 #1 Schematic in progress-TopSheet remaining
    [Buzzer_Temp_Humd_Sheet.SchDoc, Connector_Sheet.SchDoc, Controller_shee.SchDoc, Power_Sheet1.SchDoc, Power_Sheet2.SchDoc, Remote_Sensor_Unit.PrjPcb, Sheet1.SchDoc, Sheet2.SchDoc]
2023-08-18 #1 Schematic Completed
    [Buzzer_Temp_Humd_Sheet.SchDoc, Connector_Sheet.SchDoc, Controller_Sheet.SchDoc, Controller_shee.SchDoc, Power_Sheet1.SchDoc, Power_Sheet2.SchDoc, Relay_Buzzer_Temp_Humd_Sheet.SchDoc, Remote_Sensor_Unit.PrjPcb]
2023-08-18 #1 TopSheet adjusted
    [Controller_Sheet.SchDoc, Remote_Sensor_Unit.PrjPcb, Top_Sheet.SchDoc]
2023-08-18 #1 PDF added
    [Controller_Sheet.SchDoc, Power_Sheet1.SchDoc, Power_Sheet2.SchDoc, Relay_Buzzer_Temp_Humd_Sheet.SchDoc, Remote_Sensor_Unit.PrjPcb]
2023-08-22 #1 Parts replaced
    [Connector_Sheet.SchDoc, Controller_Sheet.SchDoc, Power_Sheet1.SchDoc, Power_Sheet2.SchDoc, Remote_Sensor_Unit.PrjPcb, Top_Sheet.SchDoc]
2023-08-22 #3 Changes remaining
    [Power_Sheet1.SchDoc, Power_Sheet2.SchDoc]
2023-08-23 #2 Placement in progress
    [RemoteSensorUnit.PcbDoc, Remote_Sensor_Unit.PrjPcb]
2023-08-23 #3 #2 All changes done
    [Controller_Sheet.SchDoc, Power_Sheet2.SchDoc, Top_Sheet.SchDoc]
2023-08-23 #3 netlabel correction done
    [Power_Sheet2.SchDoc, Remote_Sensor_Unit.PrjPcb, Top_Sheet.SchDoc]
2023-08-24 #3 C29 changed from 10nF(0402) to 10uF(0402) as suggested in datasheet.
    [Controller_Sheet.SchDoc]
2023-08-24 #1 #2 Esd added for POGO
    [Connector_Sheet.SchDoc, Controller_Sheet.SchDoc]
2023-08-24 #1 PDF updated
    [Controller_Sheet.SchDoc, Remote_Sensor_Unit.PrjPcb]
2023-08-25 Placement in progress
    [RemoteSensorUnit.PcbDoc, Remote_Sensor_Unit.PrjPcb]
2023-08-28 #2 #1 BME680 sensor added and OLED connector edited
    [Controller_Sheet.SchDoc, Relay_Buzzer_Temp_Humd_Sheet.SchDoc, Top_Sheet.SchDoc]
2023-08-28 #2 Finalizing Placement
    [RemoteSensorUnit.PcbDoc]
2023-08-29 #2 Placement in progress with consideration of Advanced OLED
    [RemoteSensorUnit.PcbDoc]
2023-08-30 #3 Routing will be started from tomorrow, all placement set except some power passives!
    [RemoteSensorUnit.PcbDoc]
2023-08-31 #2 #1 J9 connector replaced with right angle connector
    [Controller_Sheet.SchDoc]
2023-08-31 #2 Placement is done, waiting for client to approve it after that routing will begin.
    [RemoteSensorUnit.PcbDoc]
2023-09-04 #2 Routing in progress
    [RemoteSensorUnit.PcbDoc]
2023-09-05 #2 Routing in progress. 75% routing completed.
    [RemoteSensorUnit.PcbDoc]
2023-09-06 #2 In progress. PWR connections and differential remaining
    [RemoteSensorUnit.PcbDoc]
2023-09-07 #2 Finishing and DRC Errors need to be removed.
    [RemoteSensorUnit.PcbDoc, Remote_Sensor_Unit.PrjPcb]
2023-09-08 #2 Some DRC errors remaining
    [RemoteSensorUnit.PcbDoc]
2023-09-11 GNDs separated
    [Power_Sheet1.SchDoc]
2023-09-11 #2 All done, PCB size needs to be reduced as the battery holder will not be used.
    [RemoteSensorUnit.PcbDoc]
2023-09-12 #3 #1 J8 (battery connector) changed from 2P-Through Hole Pads to 1.25-2PWB
    [Connector_Sheet.SchDoc]
2023-09-12 #3 #1 Generic No ERC added to the J8
    [Connector_Sheet.SchDoc]
2023-09-12 #2 Done! Battery holder removed, Battery connector changed to JST. PCB length back to 114mm
    [RemoteSensorUnit.PcbDoc]
2023-09-18 #3 J9 connections flipped
    [Controller_Sheet.SchDoc]
2023-09-18 #2 Advance OLED connector connections modified in PCB as per flex cable requirement
    [RemoteSensorUnit.PcbDoc]
2023-09-20 #1 #2 Differential pair made same
    [Connector_Sheet.SchDoc, Controller_Sheet.SchDoc, mPCIe_Connector_Sheet.SchDoc]
2023-10-06 #1 C50, C51 and L5 added for antenna
    [Controller_Sheet.SchDoc, Remote_Sensor_Unit.PrjPcb]
2023-10-06 Client BOM added with Peripheral.
    [Client_BOM_Remote_Sensor_Unit.xlsx, Remote_Sensor_Unit.PrjPcb]
2023-10-09 #2 Passives added to the Antenna feed line. Changes done.
    [RemoteSensorUnit.PcbDoc, Remote_Sensor_Unit.PrjPcb]
2023-10-12 #2 Fresh Deliverables created.
    [Centroid_File-v1.0.csv, Connector_Sheet.SchDoc, Controller_Sheet.SchDoc, Pick Place for RemoteSensorUnit-v1.0.csv, Power_Sheet1.SchDoc, Power_Sheet2.SchDoc, Relay_Buzzer_Temp_Humd_Sheet.SchDoc, RemoteSensorUnit-v1.0.DWG]
2023-12-20 #Client BOM Update
    [Client_BOM_Remote_Sensor_Unit.xlsx]
2023-12-22 Client BOM Update.
    [Client_BOM_Remote_Sensor_Unit.xlsx]
2023-12-26 Remote Sensor Client BOM Battery Link added
    [Client_BOM_Remote_Sensor_Unit.xlsx]
2024-02-20 #5 Relay Update in PCB.
    [Centroid.csv, Centroid_File-v1.0.csv, Controller_Sheet.SchDoc, Pick Place for RemoteSensorUnit-v1.0.csv, RemoteSensorUnit-v1.0.DWG, RemoteSensorUnit-v1.0.DXF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]
2024-04-05 #5 All required changes done
    [Controller_Sheet.SchDoc, Power_Sheet1.SchDoc, Relay_Buzzer_Temp_Humd_Sheet.SchDoc, Remote_Sensor_Unit-v1.1.PrjPcb]
